sooarees/function_signal_generator_PI3/etapa_2/README.md

# Etapa 2

Nesta etapa, iniciamos os testes práticos do gerador de funções. O trabalho ficou dividido entre a validação dos displays touchscreen, o desenvolvimento de um protótipo da interface e os primeiros testes do filtro de reconstrução analógica. O sistema completo ainda não foi integrado ao STM32; primeiro verificamos o funcionamento dos módulos e as principais decisões de hardware e software em bancada.

## Desenvolvimento

### 1. Display touchscreen

Foram avaliados dois shields TFT touchscreen de 2,4", com resolução de 240 × 320 pixels e interface paralela de 8 bits. Os testes foram feitos em um Arduino UNO R3 [5] com as bibliotecas MCUFRIEND_kbv, Adafruit GFX e Adafruit TouchScreen [1][2][3]. O exemplo gráfico foi usado para verificar cores, linhas, textos, rotação e rolagem. Em seguida, o painel resistivo foi calibrado e testado com botões virtuais.

A tabela abaixo resume os módulos avaliados e os resultados obtidos:

| Display | Controlador | Calibração do touch | Resultado |
|:--|:-:|:-:|:-:|
| 1 | RM68090 (`0x6809`) | `LEFT=144`, `RT=883`, `TOP=109`, `BOT=870` | Aprovado |
| 2 | LGDP4532 (`0x4532`) | `LEFT=186`, `RT=889`, `TOP=186`, `BOT=876` | Aprovado |

Os dois módulos funcionaram, mas o **RM68090** foi escolhido como display principal por possuir documentação mais completa [4] e suporte direto na biblioteca. O LGDP4532 exigiu a ativação manual de seu controlador no arquivo de configuração da MCUFRIEND_kbv e ficou como módulo reserva. Os procedimentos e valores de calibração estão detalhados em [hardware/display.md](./hardware/display.md).

### 2. Protótipo da interface

Antes da migração para o STM32, desenvolvemos uma interface funcional no Arduino UNO usando o display reserva. A tela inicial permite escolher as formas de onda senoidal, quadrada, triangular e dente de serra. Também há telas para ajustar frequência, amplitude e offset, além do duty cycle da onda quadrada, com barra deslizante, botões de incremento e decremento e opções para salvar ou cancelar.

Os limites usados no protótipo seguem os requisitos iniciais: frequência de **1 Hz a 20 kHz**, amplitude de **0 a 10 Vpp**, offset de **−5 V a +5 V** e duty cycle de **0% a 100%**, disponível somente para a onda quadrada. Nesta etapa, a interface ainda não gera o sinal; seu objetivo é validar o tamanho dos botões, a leitura do toque, a organização das telas e o fluxo de navegação.

Como o Arduino UNO possui pouca memória, os elementos são desenhados diretamente no display, sem framebuffer. As atualizações foram concentradas nas regiões alteradas para evitar redesenhos completos. O protótipo está em [software/interface_arduino/interface_arduino.ino](./software/interface_arduino/interface_arduino.ino), e seu funcionamento está resumido em [software/README.md](./software/README.md).

### 3. Filtro de reconstrução analógica

Inicialmente, foi considerado um filtro passa-baixa simples para suavizar os degraus produzidos pelo DAC. Depois, optamos por testar uma aproximação de Bessel, que apresenta fase aproximadamente linear e atraso de grupo mais constante na faixa de passagem, além de pouco overshoot [6][7]. Essas características são úteis quando se deseja reduzir a distorção temporal do sinal filtrado.

Uma topologia foi selecionada e simulada antes da montagem. Embora a resposta teórica tenha sido satisfatória, o circuito em bancada não reproduziu corretamente sinais com transições rápidas. O problema ficou mais evidente na onda quadrada. A partir desse resultado, decidimos tratar a geração da onda quadrada separadamente do caminho usado para as demais formas de onda, enquanto o filtro será revisto nos próximos testes.

## Testes

Os testes em bancada abrangeram a interface digital e o condicionamento analógico. A tabela a seguir reúne as principais validações realizadas nesta etapa:

| Item avaliado | Resultado | Observação |
|:--|:-:|:--|
| Display RM68090 | Aprovado | Inicialização e recursos gráficos funcionando |
| Display LGDP4532 | Aprovado | Exigiu habilitação manual na biblioteca |
| Touchscreen resistivo | Aprovado | Calibração e botões virtuais funcionando |
| Protótipo da interface | Aprovado | Navegação e ajustes validados |
| Protótipo do filtro Bessel | Não aprovado | Resposta prática diferente da simulação |

Os testes confirmaram que os dois displays e o touchscreen podem ser usados no desenvolvimento da interface. A navegação também se mostrou adequada para o tamanho da tela, e os parâmetros puderam ser alterados sem travamentos perceptíveis. O protótipo ainda será adaptado ao STM32 e integrado à geração real dos sinais.

Na parte analógica, o resultado do filtro mostrou que a simulação não foi suficiente para validar o comportamento com todas as formas de onda. A próxima etapa deverá revisar os valores e a topologia do filtro, repetir as medições e definir o caminho separado da onda quadrada.

## Referências (links/datasheets/livros)

1. [MCUFRIEND_kbv](https://github.com/prenticedavid/MCUFRIEND_kbv)
2. [Adafruit GFX Library](https://github.com/adafruit/Adafruit-GFX-Library)
3. [Adafruit TouchScreen](https://github.com/adafruit/Adafruit_TouchScreen)
4. [Datasheet do RM68090](https://www.crystalfontz.com/controllers/uploaded/Raydium_RM68090_v0.4.pdf)
5. [Arduino UNO R3 — documentação oficial](https://docs.arduino.cc/hardware/uno-rev3)
6. [Analog Devices — fundamentos de DDS e filtros de reconstrução](https://www.analog.com/media/en/training-seminars/design-handbooks/Technical-Tutorial-DDS/Section4.pdf)
7. SEDRA, Adel S.; SMITH, Kenneth C. *Microeletrônica*. 7. ed. São Paulo: Pearson Education do Brasil, 2017.
