sooarees/function_signal_generator_PI3/images/Etapa03_Gabinete_Impresso.jpeg

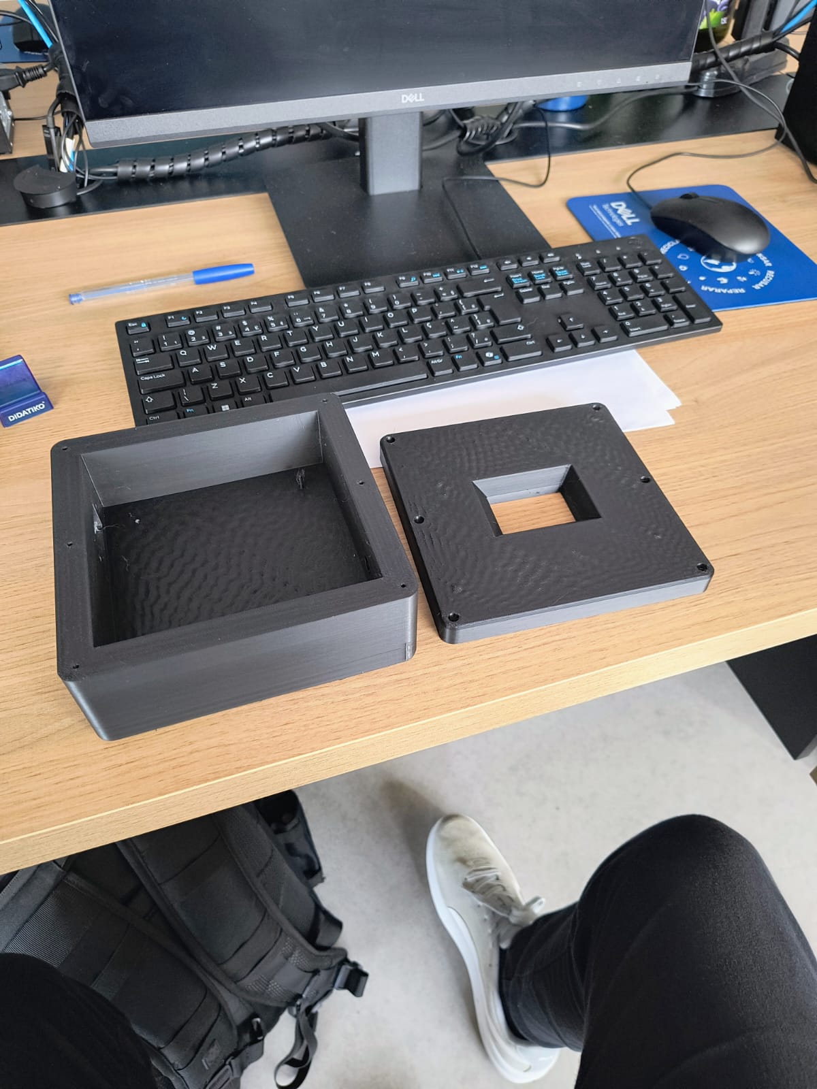
images/Etapa03_Gabinete_Impresso.jpeg
