sooarees/function_signal_generator_PI3/images/Etapa03_Gerador_Offset.png

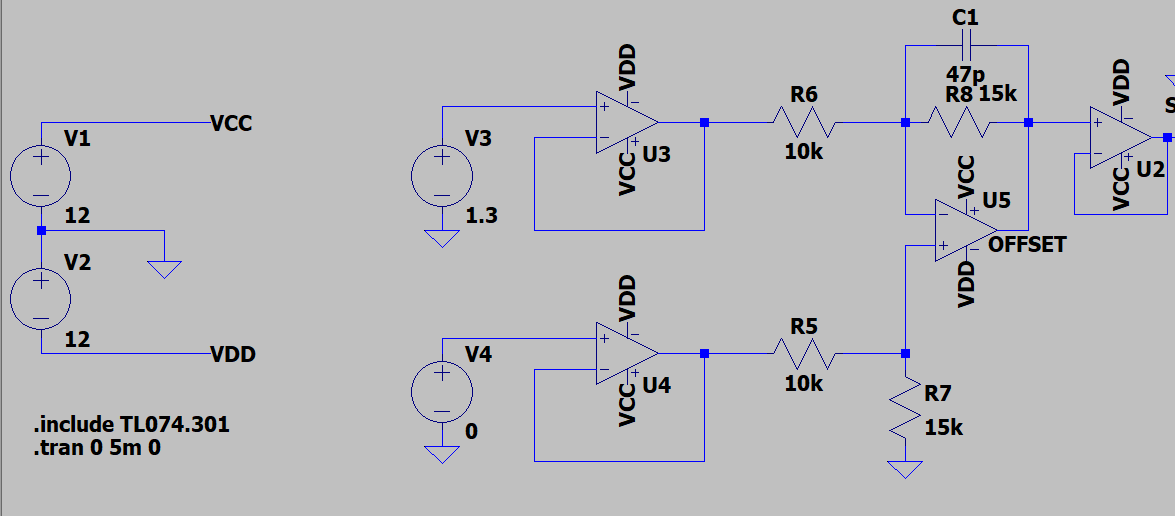
images/Etapa03_Gerador_Offset.png
