sooarees/function_signal_generator_PI3/images/Etapa03_Offset0_Amplificação.jpeg

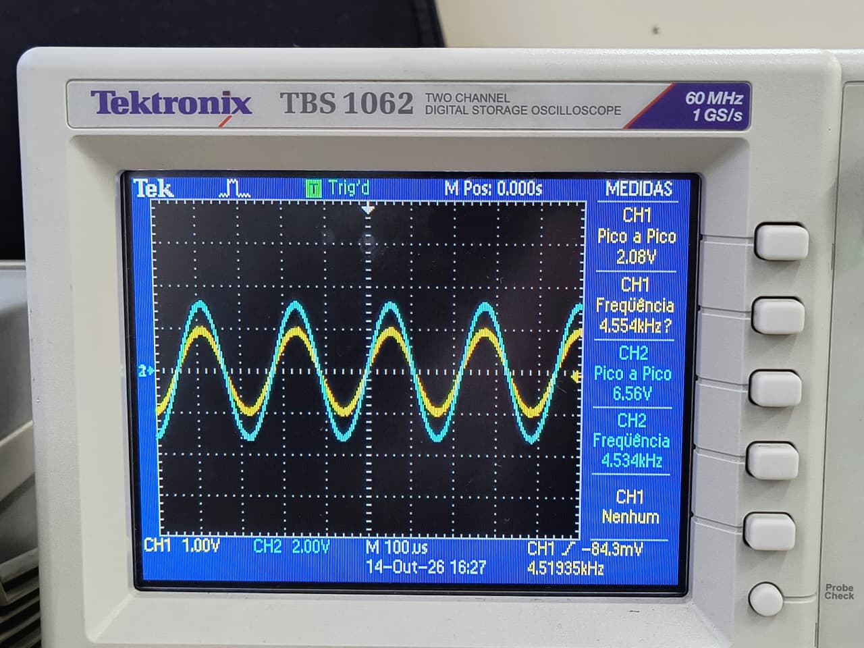
images/Etapa03_Offset0_Amplificação.jpeg
