sooarees/function_signal_generator_PI3/images/Etapa_03_OffsetPositivo_Amplificação.jpeg

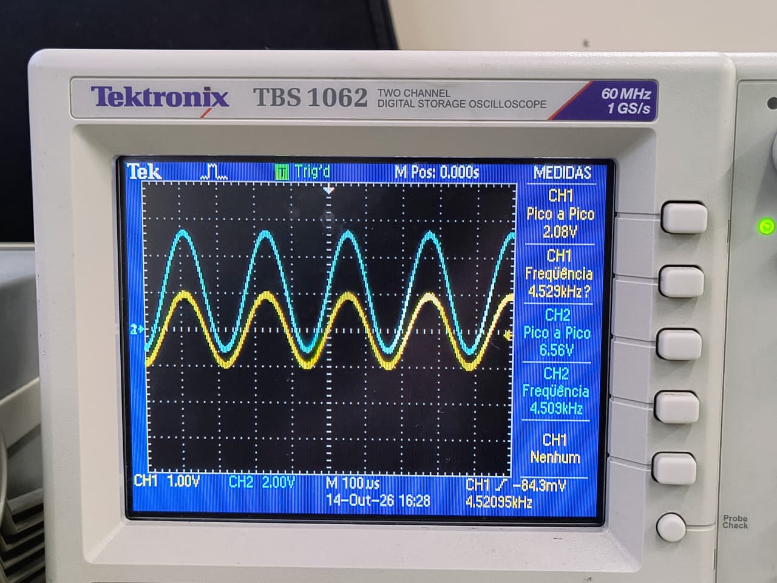
images/Etapa_03_OffsetPositivo_Amplificação.jpeg
