sooarees/function_signal_generator_PI3/etapa_4/hardware/WaveFormGenerator/GeradorDeOnda.pdf

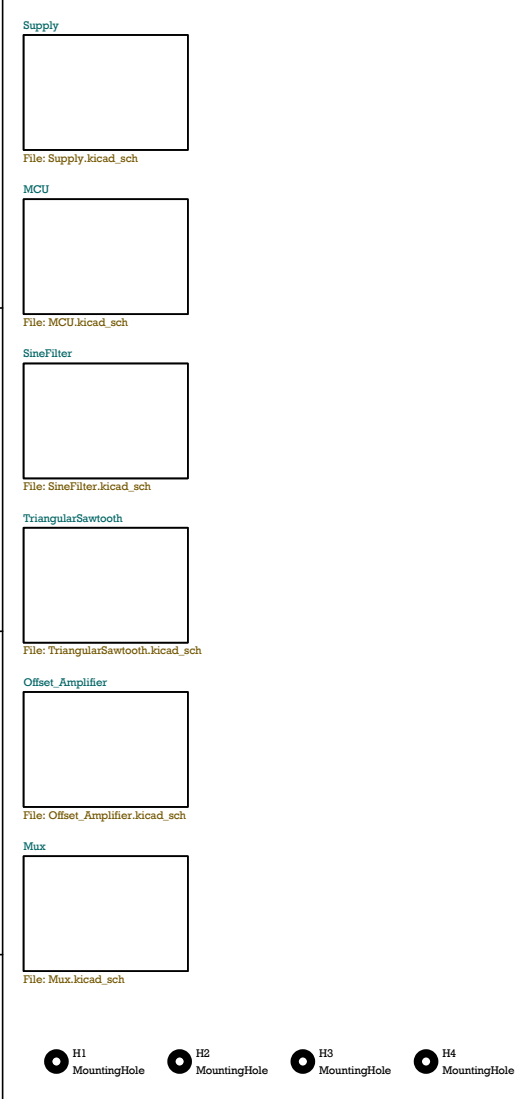
[picture p27: page 1]

Sheet: /
File: GeradorDeOnda.kicad_sch
Title: Wave Form Generator

Size: A4 | Rev: V1A

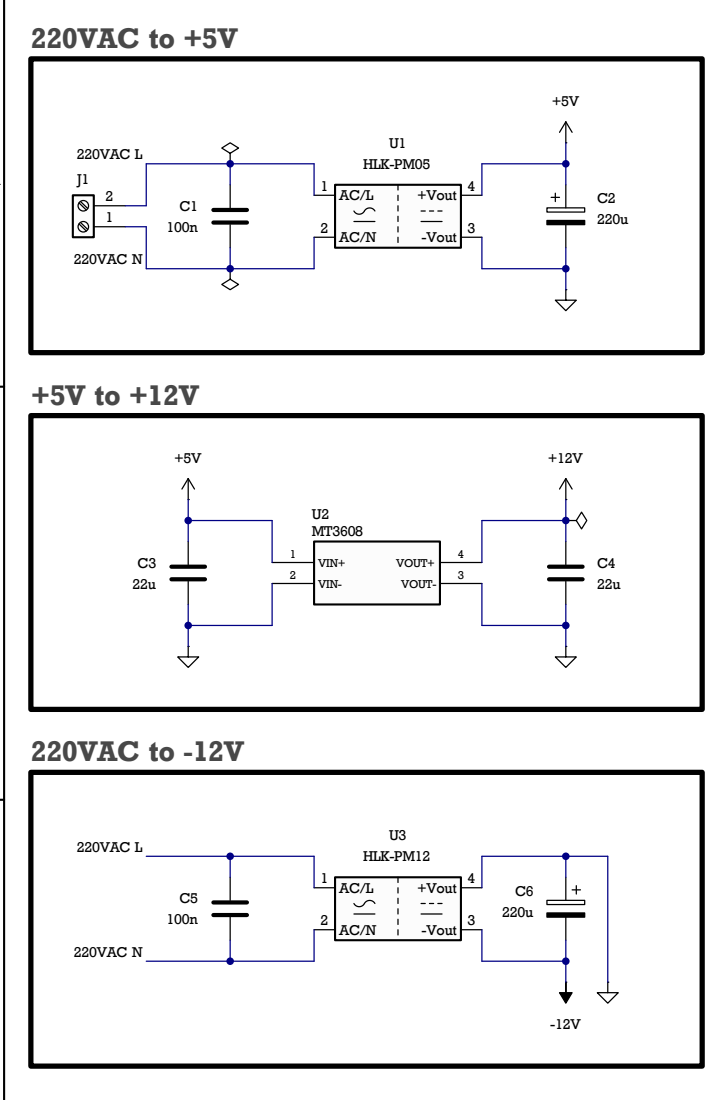
[picture p28: page 2]

IFSC
Sheet: /Supply/
File: Supply.kicad_sch
Title: Wave Form Generator

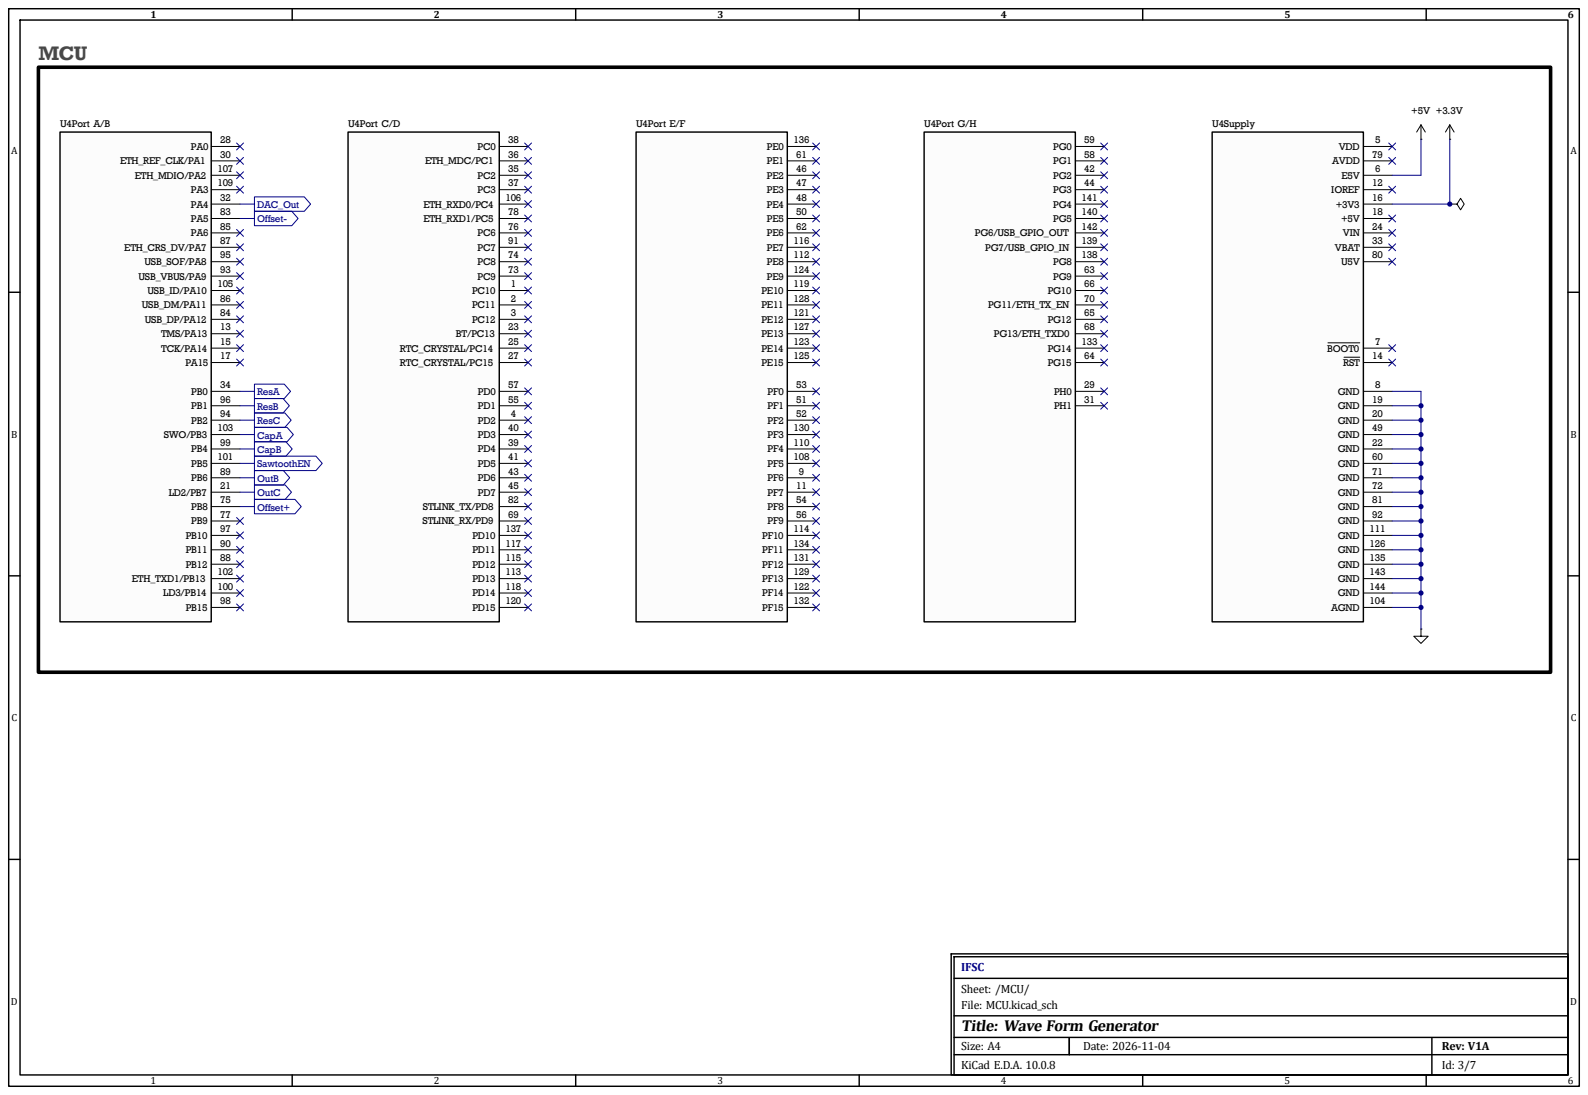
[picture p29: page 3]

SawtoothEN Offset+ OutC OutB MCU

IFSC
Sheet: /MCU/
File: MCU.kicad_sch
Title: Wave Form Generator

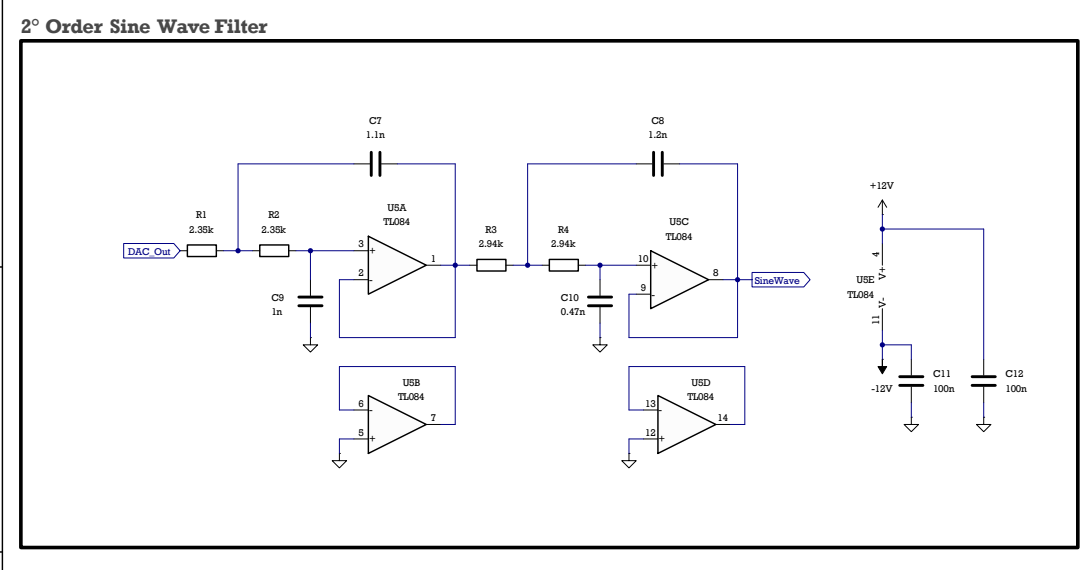
[picture p30: page 4]

SineWave DAC_Out 2° Order Sine Wave Filter

IFSC
Sheet: /SineFilter/
File: SineFilter.kicad_sch
Title: Wave Form Generator

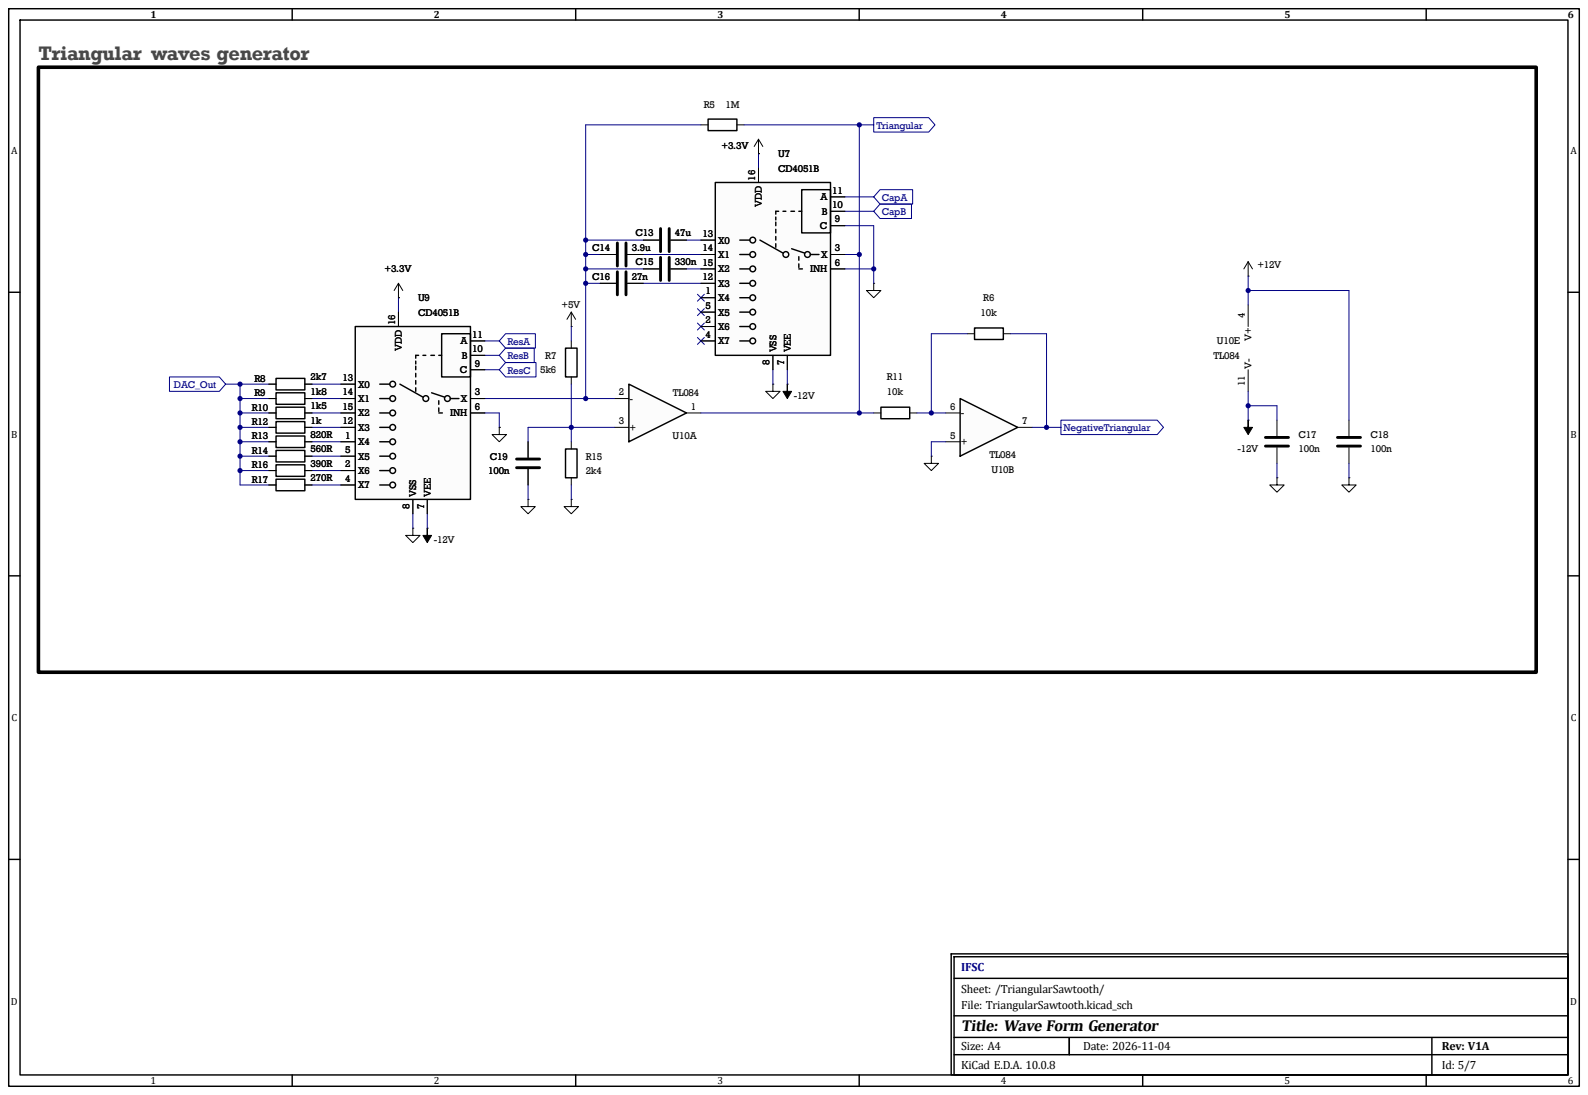
[picture p31: page 5]

IFSC
Sheet: /TriangularSawtooth/
File: TriangularSawtooth.kicad_sch
Title: Wave Form Generator

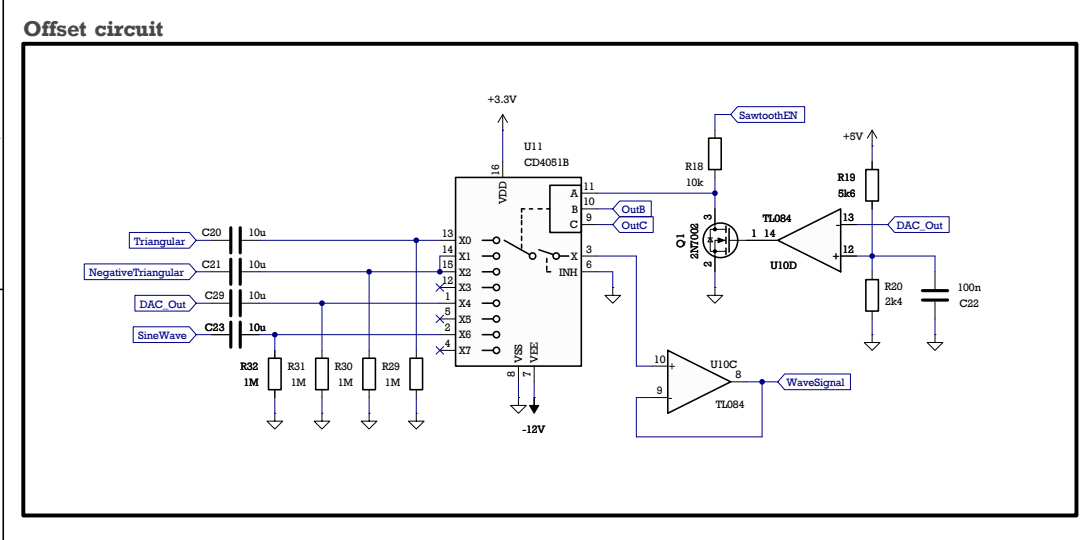
[picture p32: page 6]

IFSC
Sheet: /Mux/
File: Mux.kicad_sch
Title: Wave Form Generator

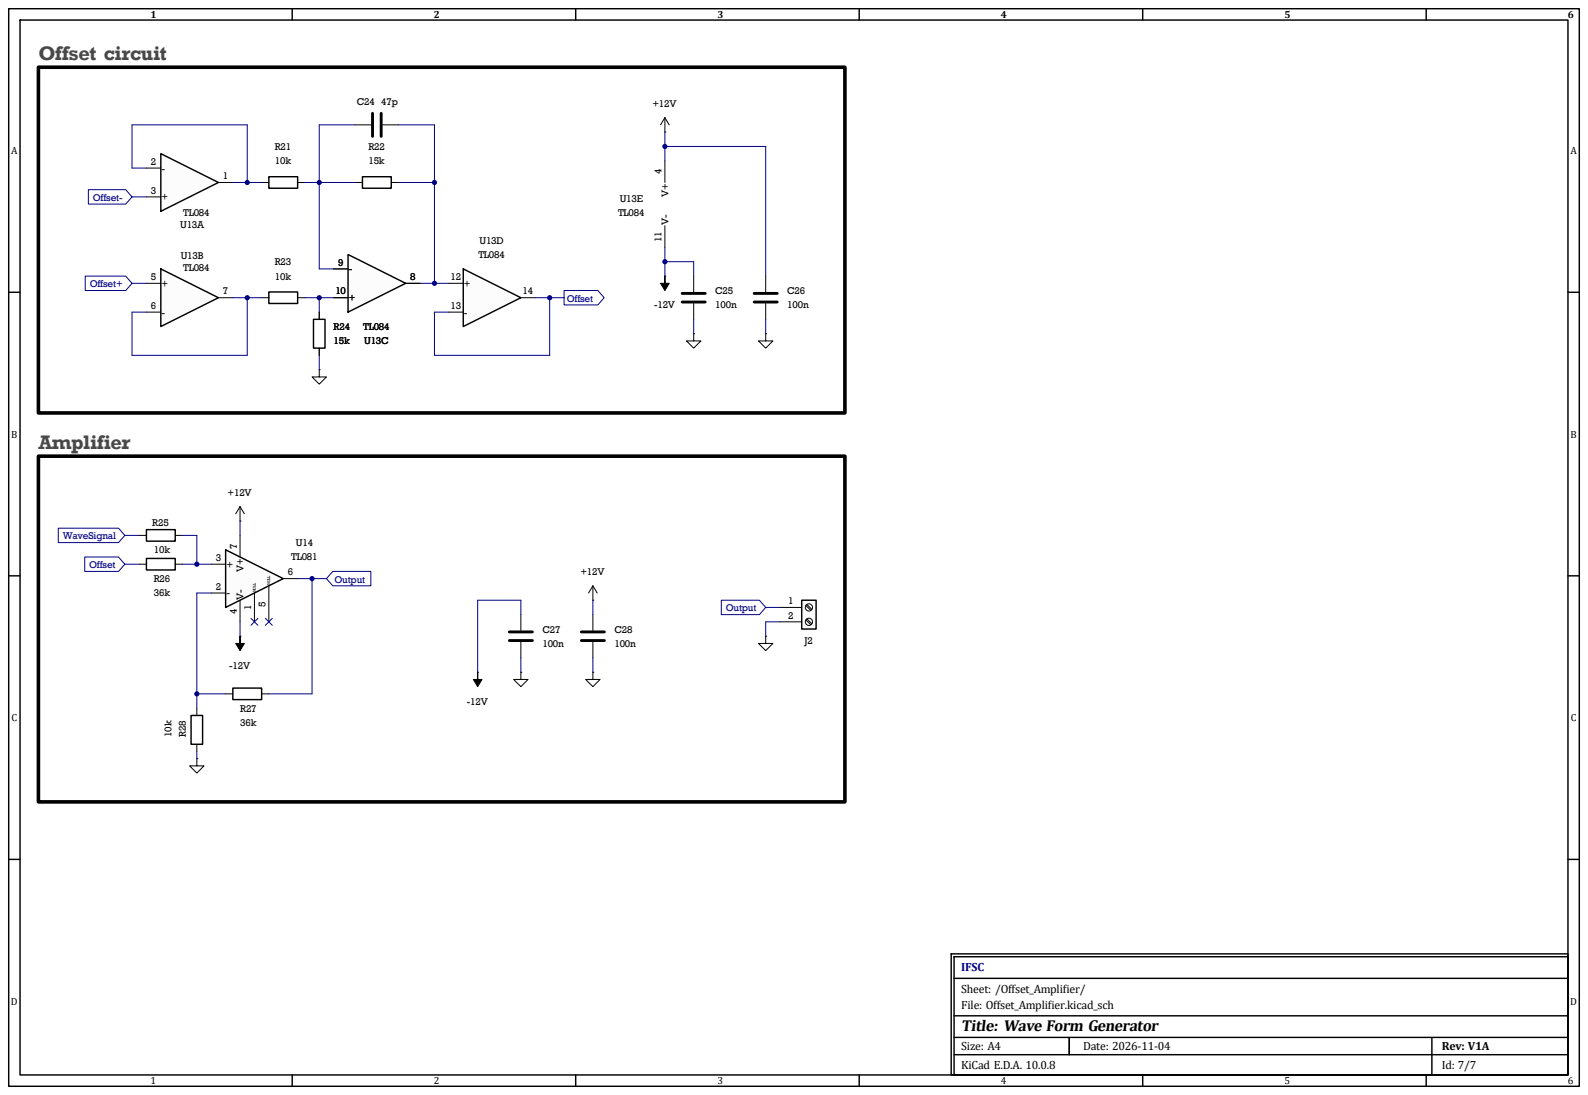
[picture p33: page 7]
