sooarees/function_signal_generator_PI3/etapa_4/hardware/WaveFormGenerator/GeradorDeOnda.kicad_sch

## KiCad design etapa_4/hardware/WaveFormGenerator/GeradorDeOnda.kicad_sch (2026-11-11)

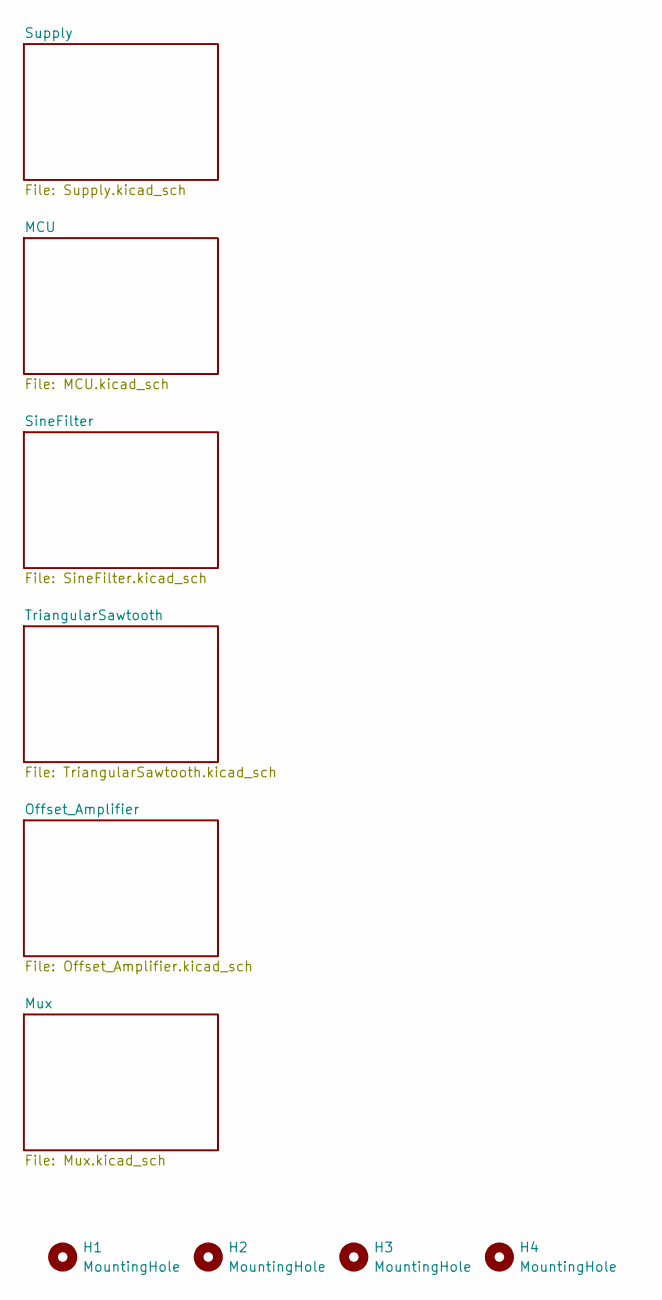
[picture p34: schematic GeradorDeOnda.kicad_sch]

Parts:
H1, H2, H3, H4: MountingHole; MountingHole_3.2mm_M3
