sooarees/function_signal_generator_PI3/etapa_4/hardware/WaveFormGenerator/Mux.kicad_sch

## KiCad design etapa_4/hardware/WaveFormGenerator/Mux.kicad_sch (2026-11-11)

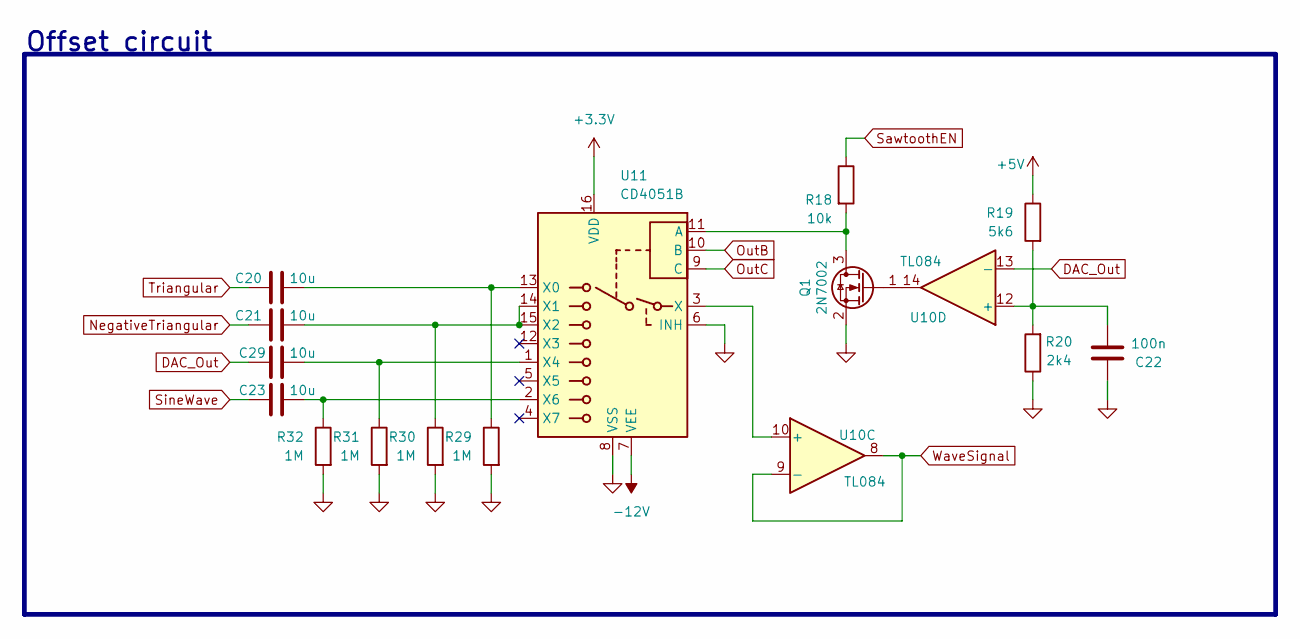
[picture p35: schematic Mux.kicad_sch]

Parts:
C20, C21, C23, C29: 10u; C_Rect_L11.0mm_W2.8mm_P10.00mm_MKT
C22: 100n; C_Rect_L11.0mm_W2.8mm_P10.00mm_MKT
Q1: 2N7002; SOT-23
R18: 10k; R_Axial_DIN0309_L9.0mm_D3.2mm_P20.32mm_Horizontal
R19: 5k6; R_Axial_DIN0309_L9.0mm_D3.2mm_P20.32mm_Horizontal
R20: 2k4; R_Axial_DIN0309_L9.0mm_D3.2mm_P20.32mm_Horizontal
R29, R30, R31, R32: 1M; R_Axial_DIN0309_L9.0mm_D3.2mm_P20.32mm_Horizontal
U10: TL084; DIP-14_W7.62mm_LongPads
U11: CD4051B; DIP-16_W7.62mm_LongPads

Connections:
+3.3V: U11.16 (VDD)
+5V: R19.1
-12V: U11.7 (VEE)
DAC_Out: C29.1, U10.13 (-)
GND: C22.2, Q1.2 (S), R20.1, R29.2, R30.2, R31.2, R32.2, U11.6 (INH), U11.8 (VSS)
NegativeTriangular: C21.1
unnamed: C20.2, R29.1, U11.13 (X0)
unnamed: C21.2, R30.1, U11.14 (X1), U11.15 (X2)
unnamed: C22.1, R19.2, R20.2, U10.12 (+)
unnamed: C23.2, R32.1, U11.2 (X6)
unnamed: C29.2, R31.1, U11.1 (X4)
unnamed: Q1.1 (G), U10.14
unnamed: Q1.3 (D), R18.2, U11.11 (A)
unnamed: U10.10 (+), U11.3 (X)
OutB: U11.10 (B)
OutC: U11.9 (C)
SawtoothEN: R18.1
SineWave: C23.1
Triangular: C20.1
WaveSignal: U10.8, U10.9 (-)

Notes on the sheet:
Offset circuit
