sooarees/function_signal_generator_PI3/etapa_4/hardware/WaveFormGenerator/Offset_Amplifier.kicad_sch

## KiCad design etapa_4/hardware/WaveFormGenerator/Offset_Amplifier.kicad_sch (2026-11-11)

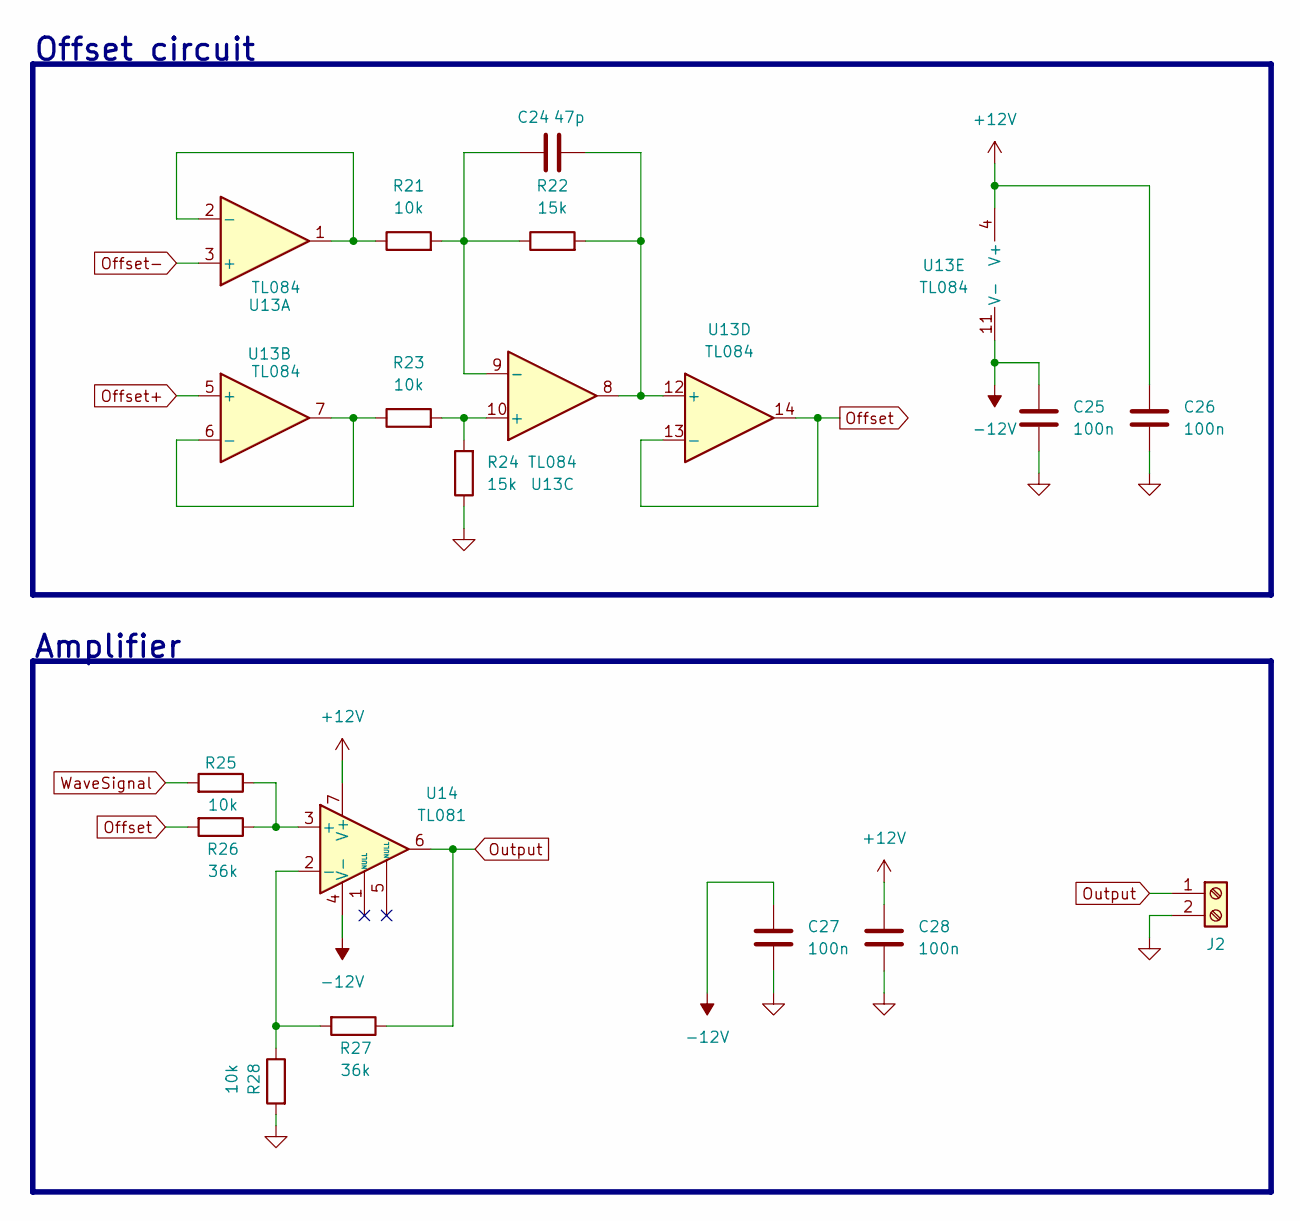
[picture p36: schematic Offset_Amplifier.kicad_sch]

Parts:
C24: 47p; C_Rect_L11.0mm_W2.8mm_P10.00mm_MKT
C25, C26, C27, C28: 100n; C_Rect_L11.0mm_W2.8mm_P10.00mm_MKT
J2: Screw_Terminal_01x02; TerminalBlock_MaiXu_MX126-5.0-02P_1x02_P5.00mm
R21, R23, R25, R28: 10k; R_Axial_DIN0309_L9.0mm_D3.2mm_P20.32mm_Horizontal
R22, R24: 15k; R_Axial_DIN0309_L9.0mm_D3.2mm_P20.32mm_Horizontal
R26, R27: 36k; R_Axial_DIN0309_L9.0mm_D3.2mm_P20.32mm_Horizontal
U13: TL084; DIP-14_W7.62mm_LongPads
U14: TL081; DIP-8_W7.62mm_LongPads

Connections:
+12V: C26.2, C28.2, U13.4 (V+), U14.7 (V+)
-12V: C25.2, C27.2, U13.11 (V-), U14.4 (V-)
GND: C25.1, C26.1, C27.1, C28.1, J2.2, R24.1, R28.2
unnamed: C24.1, R21.2, R22.1, U13.9 (-)
unnamed: C24.2, R22.2, U13.8, U13.12 (+)
unnamed: R21.1, U13.1, U13.2 (-)
unnamed: R23.1, U13.6 (-), U13.7
unnamed: R23.2, R24.2, U13.10 (+)
unnamed: R25.1, R26.1, U14.3 (+)
unnamed: R27.2, R28.1, U14.2 (-)
Offset: R26.2, U13.13 (-), U13.14
Offset+: U13.5 (+)
Offset-: U13.3 (+)
Output: J2.1, R27.1, U14.6
WaveSignal: R25.2

Notes on the sheet:
Amplifier
Offset circuit
