sooarees/function_signal_generator_PI3/etapa_4/hardware/WaveFormGenerator/SineFilter.kicad_sch

## KiCad design etapa_4/hardware/WaveFormGenerator/SineFilter.kicad_sch (2026-11-11)

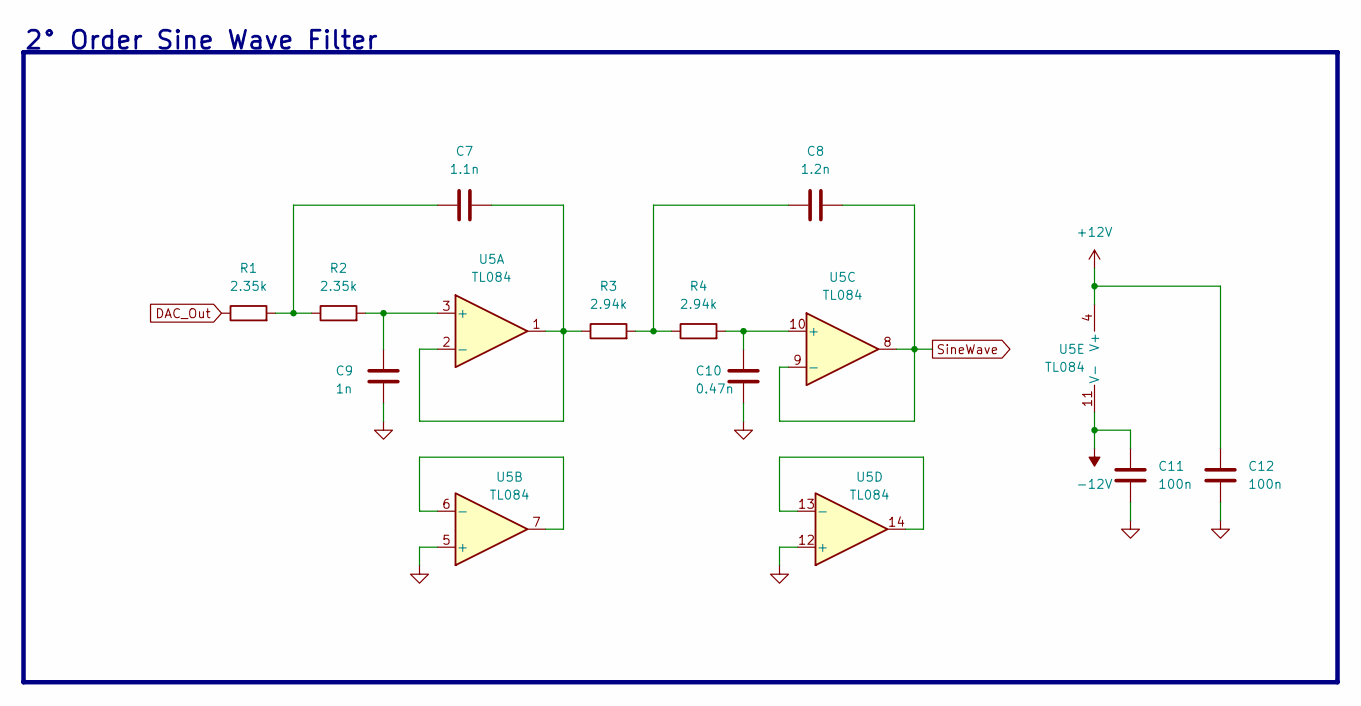
[picture p37: schematic SineFilter.kicad_sch]

Parts:
C7: 1.1n; C_Rect_L11.0mm_W2.8mm_P10.00mm_MKT
C8: 1.2n; C_Rect_L11.0mm_W2.8mm_P10.00mm_MKT
C9: 1n; C_Rect_L11.0mm_W2.8mm_P10.00mm_MKT
C10: 0.47n; C_Rect_L11.0mm_W2.8mm_P10.00mm_MKT
C11, C12: 100n; C_Rect_L11.0mm_W2.8mm_P10.00mm_MKT
R1, R2: 2.35k; R_Axial_DIN0309_L9.0mm_D3.2mm_P20.32mm_Horizontal
R3, R4: 2.94k; R_Axial_DIN0309_L9.0mm_D3.2mm_P20.32mm_Horizontal
U5: TL084; DIP-14_W7.62mm_LongPads

Connections:
+12V: C12.2, U5.4 (V+)
-12V: C11.2, U5.11 (V-)
DAC_Out: R1.1
GND: C9.1, C10.1, C11.1, C12.1, U5.5 (+), U5.12 (+)
unnamed: C7.1, R1.2, R2.1
unnamed: C7.2, R3.1, U5.1, U5.2 (-)
unnamed: C8.1, R3.2, R4.1
unnamed: C9.2, R2.2, U5.3 (+)
unnamed: C10.2, R4.2, U5.10 (+)
unnamed: U5.6 (-), U5.7
unnamed: U5.13 (-), U5.14
SineWave: C8.2, U5.8, U5.9 (-)

Notes on the sheet:
2° Order Sine Wave Filter
