sooarees/function_signal_generator_PI3/etapa_4/hardware/WaveFormGenerator/Supply.kicad_sch

## KiCad design etapa_4/hardware/WaveFormGenerator/Supply.kicad_sch (2026-11-11)

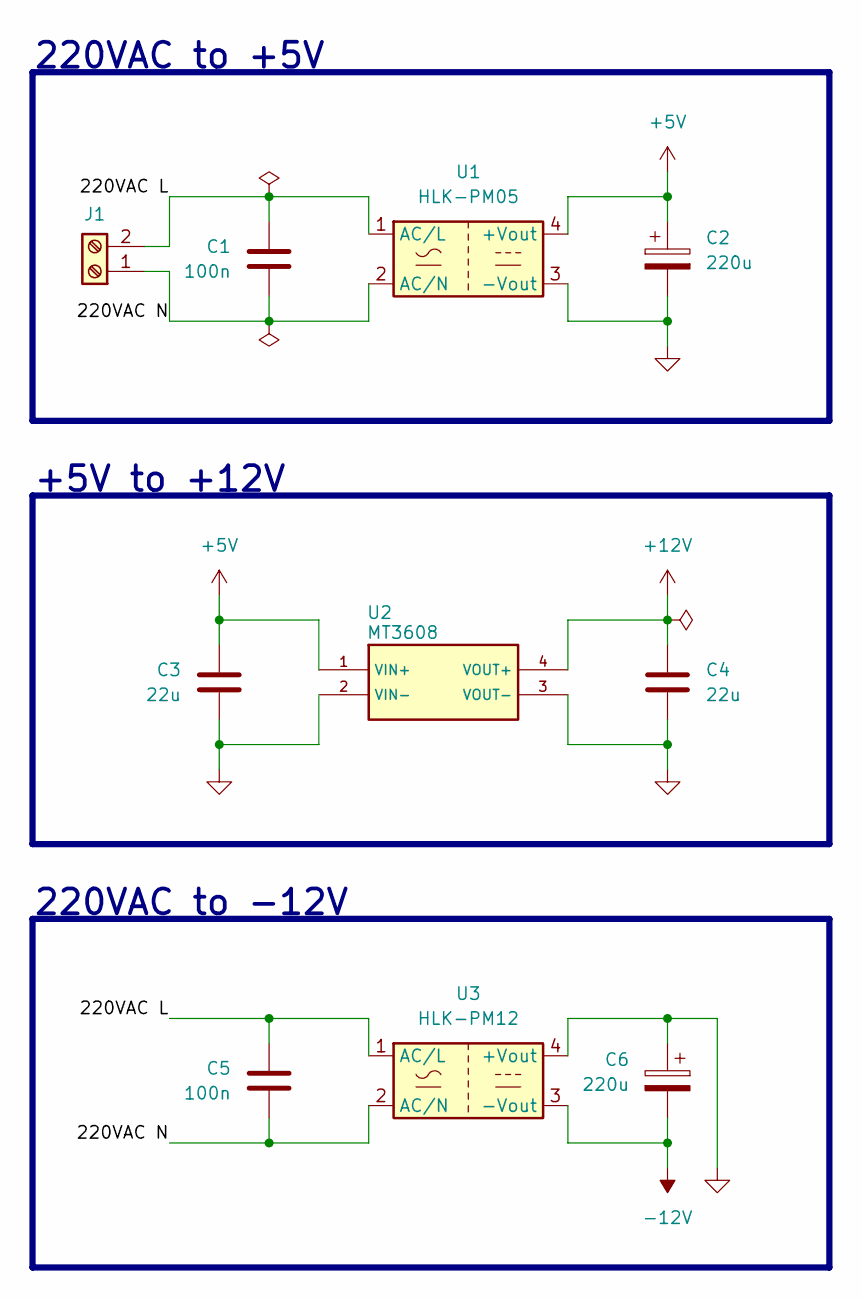
[picture p38: schematic Supply.kicad_sch]

Parts:
C1, C5: 100n; C_Rect_L11.0mm_W2.8mm_P10.00mm_MKT
C2, C6: 220u; CP_Radial_D18.0mm_P7.50mm
C3, C4: 22u; CP_Radial_D12.5mm_P5.00mm
J1: Screw_Terminal_01x02; TerminalBlock_MaiXu_MX126-5.0-02P_1x02_P5.00mm
U1: HLK-PM05; Converter_ACDC_Hi-Link_HLK-PMxx
U2: MT3608; MT3608_Module
U3: HLK-PM12; Converter_ACDC_Hi-Link_HLK-PMxx

Connections:
220VAC L: C1.1, C5.1, J1.2, U1.1 (AC/L), U3.1 (AC/L)
220VAC N: C1.2, C5.2, J1.1, U1.2 (AC/N), U3.2 (AC/N)
+5V: C2.1, C3.1, U1.4 (+Vout), U2.1 (VIN+)
+12V: C4.1, U2.4 (VOUT+)
-12V: C6.2, U3.3 (-Vout)
GND: C2.2, C3.2, C4.2, C6.1, U1.3 (-Vout), U2.2 (VIN-), U2.3 (VOUT-), U3.4 (+Vout)

Notes on the sheet:
220VAC to +5V
+5V to +12V
220VAC to -12V
