sooarees/function_signal_generator_PI3/etapa_4/hardware/WaveFormGenerator/TriangularSawtooth.kicad_sch

## KiCad design etapa_4/hardware/WaveFormGenerator/TriangularSawtooth.kicad_sch (2026-11-11)

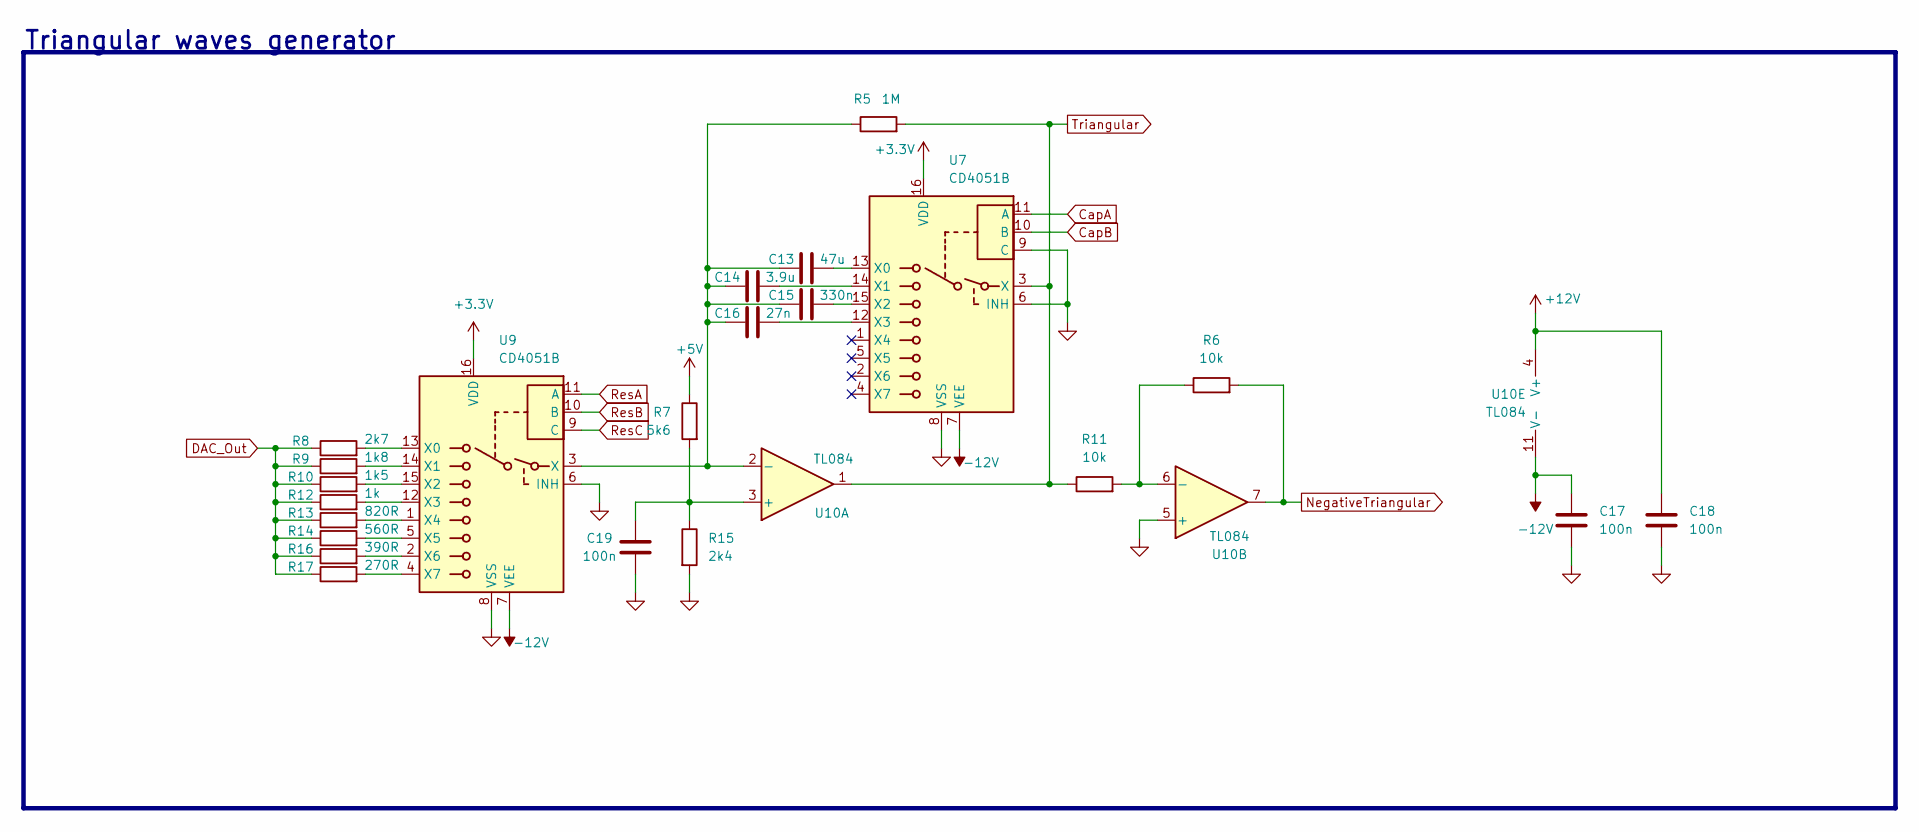
[picture p39: schematic TriangularSawtooth.kicad_sch]

Parts:
C13: 47u; C_Rect_L11.0mm_W2.8mm_P10.00mm_MKT
C14: 3.9u; C_Rect_L11.0mm_W2.8mm_P10.00mm_MKT
C15: 330n; C_Rect_L11.0mm_W2.8mm_P10.00mm_MKT
C16: 27n; C_Rect_L11.0mm_W2.8mm_P10.00mm_MKT
C17, C18, C19: 100n; C_Rect_L11.0mm_W2.8mm_P10.00mm_MKT
R5: 1M; R_Axial_DIN0309_L9.0mm_D3.2mm_P20.32mm_Horizontal
R6, R11: 10k; R_Axial_DIN0309_L9.0mm_D3.2mm_P20.32mm_Horizontal
R7: 5k6; R_Axial_DIN0309_L9.0mm_D3.2mm_P20.32mm_Horizontal
R8: 2k7; R_Axial_DIN0309_L9.0mm_D3.2mm_P20.32mm_Horizontal
R9: 1k8; R_Axial_DIN0309_L9.0mm_D3.2mm_P20.32mm_Horizontal
R10: 1k5; R_Axial_DIN0309_L9.0mm_D3.2mm_P20.32mm_Horizontal
R12: 1k; R_Axial_DIN0309_L9.0mm_D3.2mm_P20.32mm_Horizontal
R13: 820R; R_Axial_DIN0309_L9.0mm_D3.2mm_P20.32mm_Horizontal
R14: 560R; R_Axial_DIN0309_L9.0mm_D3.2mm_P20.32mm_Horizontal
R15: 2k4; R_Axial_DIN0309_L9.0mm_D3.2mm_P20.32mm_Horizontal
R16: 390R; R_Axial_DIN0309_L9.0mm_D3.2mm_P20.32mm_Horizontal
R17: 270R; R_Axial_DIN0309_L9.0mm_D3.2mm_P20.32mm_Horizontal
U7, U9: CD4051B; DIP-16_W7.62mm_LongPads
U10: TL084; DIP-14_W7.62mm_LongPads

Connections:
+3.3V: U7.16 (VDD), U9.16 (VDD)
+5V: R7.1
+12V: C18.2, U10.4 (V+)
-12V: C17.2, U7.7 (VEE), U9.7 (VEE), U10.11 (V-)
CapA: U7.11 (A)
CapB: U7.10 (B)
DAC_Out: R8.1, R9.1, R10.1, R12.1, R13.1, R14.1, R16.1, R17.1
GND: C17.1, C18.1, C19.2, R15.2, U7.6 (INH), U7.8 (VSS), U7.9 (C), U9.6 (INH), U9.8 (VSS), U10.5 (+)
NegativeTriangular: R6.2, U10.7
unnamed: C13.1, C14.1, C15.1, C16.1, R5.1, U9.3 (X), U10.2 (-)
unnamed: C13.2, U7.13 (X0)
unnamed: C14.2, U7.14 (X1)
unnamed: C15.2, U7.15 (X2)
unnamed: C16.2, U7.12 (X3)
unnamed: C19.1, R7.2, R15.1, U10.3 (+)
unnamed: R8.2, U9.13 (X0)
unnamed: R9.2, U9.14 (X1)
unnamed: R10.2, U9.15 (X2)
unnamed: R6.1, R11.2, U10.6 (-)
unnamed: R12.2, U9.12 (X3)
unnamed: R13.2, U9.1 (X4)
unnamed: R14.2, U9.5 (X5)
unnamed: R16.2, U9.2 (X6)
unnamed: R17.2, U9.4 (X7)
ResA: U9.11 (A)
ResB: U9.10 (B)
ResC: U9.9 (C)
Triangular: R5.2, R11.1, U7.3 (X), U10.1

Notes on the sheet:
Triangular waves generator
