sooarees/function_signal_generator_PI3/(commit log)

2026-09-03 images adjust
    ajuste dos diagramas de blocos
2026-09-10 Add files via upload
    Adicionado Diagrama de Blocos da Etapa 01.
2026-09-10 Atualização do README da Etapa 01
    Adicionado Diagrama de Blocos e alterada a descrição da seleção do MCU.
2026-09-10 Tirei uma vírgula
2026-09-10 Imagem deletada para correção
2026-09-10 Novo Diagrama de Blocos
2026-09-10 Update do README
    Inserida a justificativa por não utilizar uma topologia analógica para geração dos sinais.
2026-09-10 Diagrama de Blocos atualizado
2026-09-24 Tabela Display
    Correção de espaçamento na tabela dos displays.
2026-10-01 Interface Básica
    Interface feito no arduino UNO usando o display secundario e documentação
2026-10-02 Adição do Diagrama de Blocos da Etapa 02
    Alteração do circuito de alimentação, na topologia dos filtros e na do amplificador de diferenças.
2026-10-02 Atualização da descrição
    Novo Diagrama de Blocos e itens do circuito de alimentação.
2026-10-02 Atualização do README com informações do hardware
    Comentários sobre a escolha de filtro, testes e resultados.
2026-11-08 Atualização das descrições
    Atualização dos arquivos markdown com as informações referentes à geração de onda quadrada, triangular e dente de serra e com o projeto de PCI.
2026-11-08 Adição de imagens e projeto de PCI
    Adição de imagens da Etapa 03 referentes ao gerador de onda triangular e dente de serra e adição do projeto de PCI no KiCAD.
2026-11-08 Correções de valores e adição da planilha de cálculos
    Correção dos valores utilizados no integrador, adição da planilha de cálculo de resistores para o mux e alteração da extensão das imagens nas citações da Etapa 03
2026-11-08 Revert "Correções de valores e adição da planilha de cálculos"
    This reverts commit ab925aae970420ab2d138a3e387689c4d39705aa.
2026-11-11 Adicionados arquivos de hardware
    Esquemático atualizado.
